ColinNg/PositronV3/CAD  files/3D printed Parts/Parametric Synchromesh Drive Pulley by Qiblical/Parametric_Synchromesh_Drive_Pulley_5427806/images/3_81_Synchromesh_Pulley.png

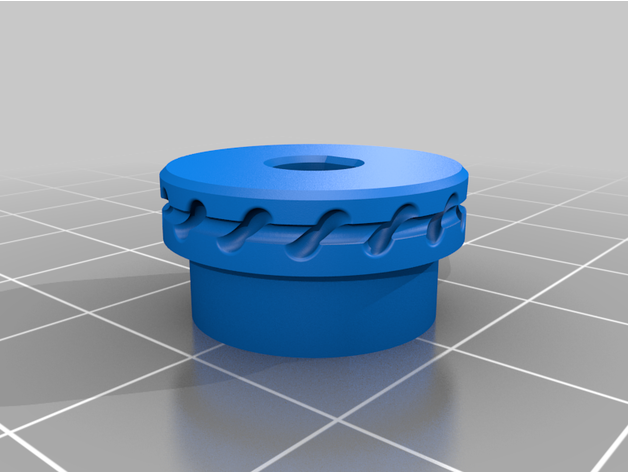
CAD files/3D printed Parts/Parametric Synchromesh Drive Pulley by Qiblical/Parametric_Synchromesh_Drive_Pulley_5427806/images/3_81_Synchromesh_Pulley.png
