ColinNg/PositronV3/CAD  files/3D printed Parts/Parametric Synchromesh Drive Pulley by Qiblical/Parametric_Synchromesh_Drive_Pulley_5427806/README.txt

Parametric Synchromesh Drive Pulley by Qiblical on Thingiverse: https://www.thingiverse.com/thing:5427806
