ColinNg/PositronV3/CAD  files/3D printed Parts/Parametric Synchromesh Drive Pulley by Qiblical/Parametric_Synchromesh_Drive_Pulley_5427806/images/featured_preview_IMG_20220710_001406016.jpg

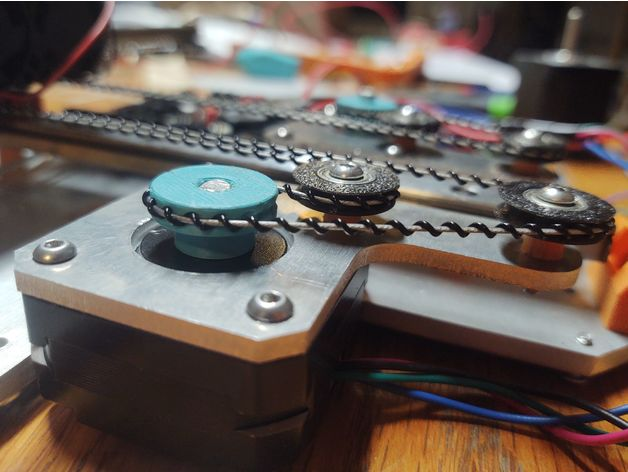
CAD files/3D printed Parts/Parametric Synchromesh Drive Pulley by Qiblical/Parametric_Synchromesh_Drive_Pulley_5427806/images/featured_preview_IMG_20220710_001406016.jpg
