ColinNg/PositronV3/CAD  files/3D printed Parts/Extruder Slider Arm.stl

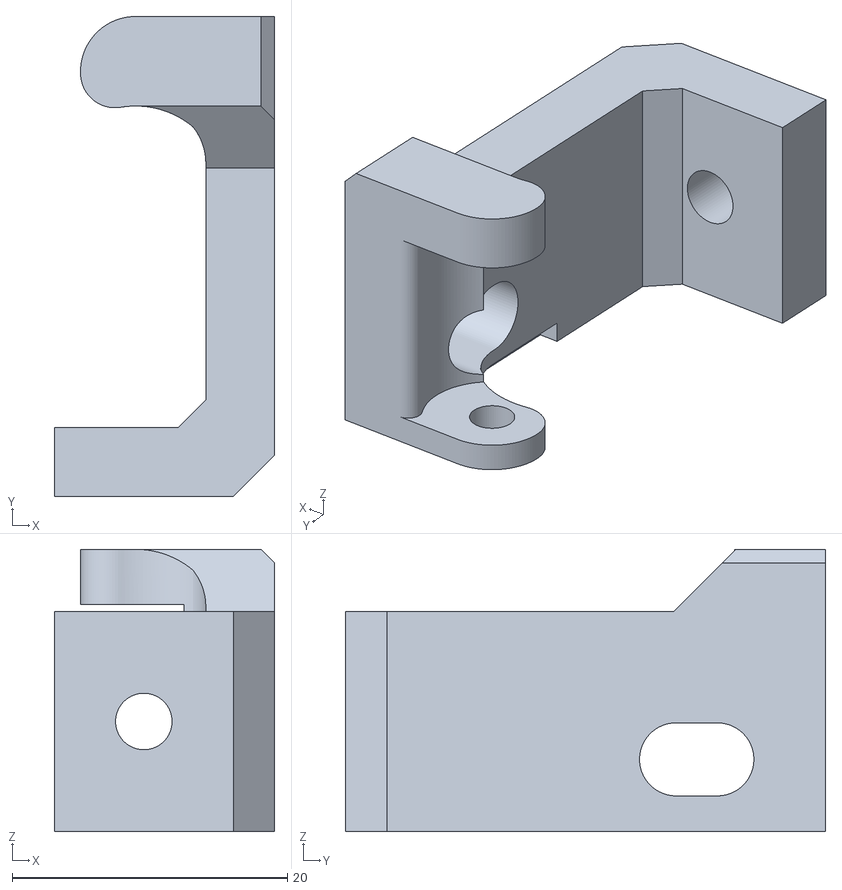
[picture p4: CAD file, 2025-05-02]
CAD files/3D printed Parts/Extruder Slider Arm.stl
16.0 x 34.9 x 20.5
