ColinNg/PositronV3/CAD  files/3D printed Parts/3D printed toolhead interconnect.stl

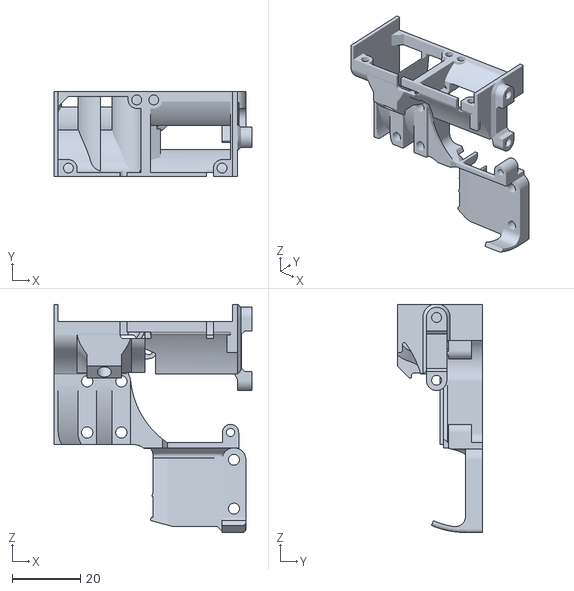
[picture p5: CAD file, 2023-12-30]
CAD files/3D printed Parts/3D printed toolhead interconnect.stl
57.9 x 25.0 x 66.8
