ColinNg/PositronV3/(list of files, cad)

Other CAD files:
CAD files/3D printed Parts/Parametric Synchromesh Drive Pulley by Qiblical/Parametric_Synchromesh_Drive_Pulley_5427806/files/Parametric_Synchromesh_Drive_Pulley_v15.f3d
