ColinNg/PositronV3/Toolhead PCB/Toolhead PCB.kicad_pcb

## KiCad design Toolhead PCB/Toolhead PCB.kicad_pcb (2025-11-05)

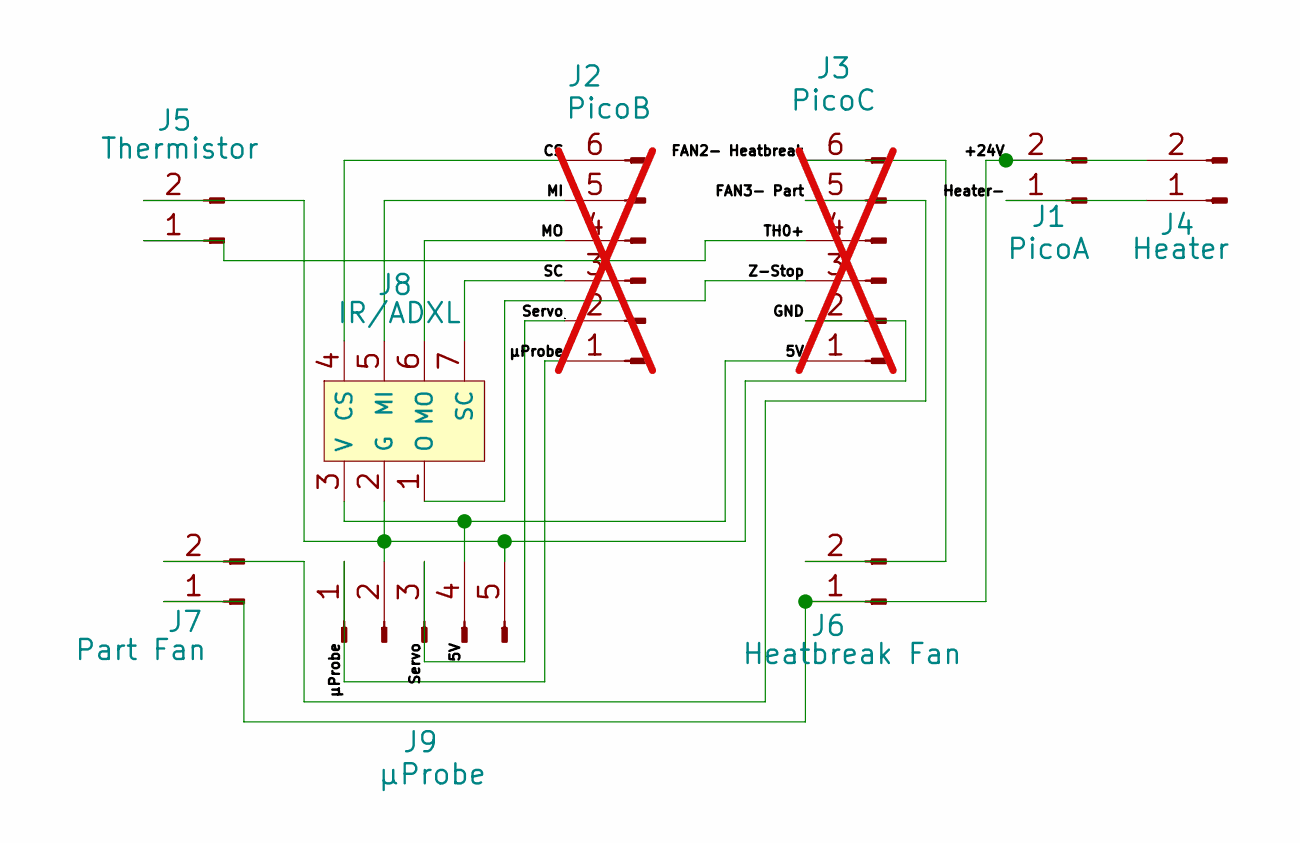
[picture p6: schematic Toolhead PCB.kicad_sch, JourneyMaker Toolhead PCB]

Parts:
J1: PicoA; SolderWire-0.5sqmm_1x02_P4.8mm_D0.9mm_OD2.3mm
J2: PicoB; JST_PH_B6B-PH-K_1x06_P2.00mm_Vertical; not fitted
J3: PicoC; JST_PH_B6B-PH-K_1x06_P2.00mm_Vertical; not fitted
J4: Heater; AMASS_XT30UPB-M_1x02_P5.0mm_Vertical
J5: Thermistor; JST_XH_S2B-XH-A_1x02_P2.50mm_Horizontal
J6: Heatbreak Fan; JST_XH_B2B-XH-A_1x02_P2.50mm_Vertical
J7: Part Fan; JST_XH_B2B-XH-A_1x02_P2.50mm_Vertical
J8: IR/ADXL; Muon 3D IR Bed Probe with ADXL345
J9: µProbe; JST_PH_B5B-PH-K_1x05_P2.00mm_Vertical

Connections:
/5V: J3.1, J8.3 (V), J9.4
/+24V: J1.2, J4.2, J6.1, J7.1
/CS: J2.6, J8.4 (CS)
/FAN2- Heatbreak: J3.6, J6.2
/FAN3- Part: J3.5, J7.2
/GND: J3.2, J5.2, J8.2 (G), J9.2, J9.5
/Heater-: J1.1, J4.1
/MI: J2.5, J8.5 (MI)
/MO: J2.4, J8.6 (MO)
/SC: J2.3, J8.7 (SC)
/Servo: J2.2, J9.3
/TH0+: J3.4, J5.1
/Z-Stop: J3.3, J8.1 (O)
/µProbe: J2.1, J9.1

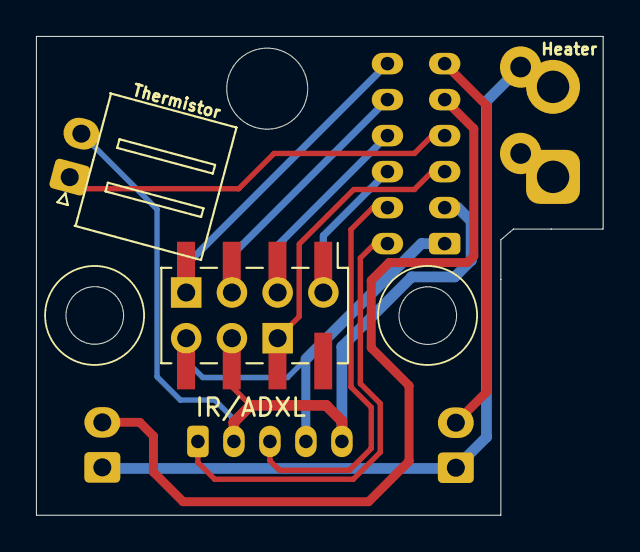
[picture p7: board Toolhead PCB.kicad_pcb from above]

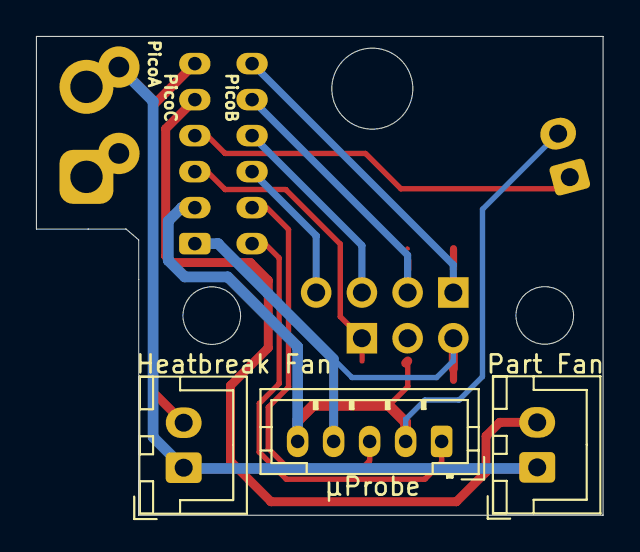
[picture p8: board Toolhead PCB.kicad_pcb from below]

Board: 2 copper layers, 31.5 x 26.6 mm, 12 parts (6 on the bottom side), 14 nets.

Other parts of the board:
Hole: Hole 3.2mm; MountingHole_3.2mm_M3
Hole#2: Capacitor Hole 4.5mm; MountingHole_4.5mm
Hole#3: Hole 3.2mm; MountingHole_3.2mm_M3
