ColinNg/PositronV3/(commit log)

2023-12-30 Parametric Synchromesh Drive Pulley by Qiblical on Thingiverse: https://www.thingiverse.com/thing:5427806
    [Parametric_Synchromesh_Drive_Pulley_v15.f3d]
2023-12-30 3D_printed_toolhead_interconnect_fixed.stl from Sample Name, Discord, 2022-10-20 07:57 https://discord.com/channels/977582747939897344/977582937853808730/1032668809204617317
    [3D printed toolhead interconnect.stl]
2023-12-30 Remove image of unintentional holes
2025-05-02 Fix typo in name
    [Extruder Slider Arm.stl]
2025-09-10 Initial commit of schematic for JourneyMaker Toolhead PCB: - J1 Amass XT30PW-M from SKR Pico for Hot End Heater - J2 JST PH 2.0 6-pin from SKR Pico for Muon IR Bed Probe and Fans - J3 JST PH 2.0 6-pi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
    [Toolhead PCB.kicad_pcb, Toolhead PCB.kicad_sch]
2025-09-10 Schematic and PCB for JourneyMaker Toolhead PCB: - J1 Soldered wires from SKR Pico for Hot End Heater - J2 JST PH 2.0 6-pin from SKR Pico for BQ MicroProbe and Muon IR Probe's ADXL345 - J3 JST PH 2.0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
    [Toolhead PCB.kicad_pcb, Toolhead PCB.kicad_sch]
2025-09-10 Used wider traces for heater, fans, thermistor, microprobe power, etc.
    [Toolhead PCB.kicad_pcb, Toolhead PCB.kicad_sch]
2025-09-10 Combine a through-hole and an SMD connector to get the passthrough holes and vias.
    [Toolhead PCB.kicad_pcb, Toolhead PCB.kicad_sch]
2025-09-10 JST connectors are soldered to the back: added 8 vias for signal and 2 vias for fan power. Added mounting holes (but have not resolved clearances).
    [Toolhead PCB.kicad_pcb]
2025-09-11 Holes for mounting. Moved traces to avoid holes. Moved most vias to the large pads. Changed the ADXLL345 wire order so it would route better. Made Schematic match PCB.
    [Toolhead PCB.kicad_pcb, Toolhead PCB.kicad_sch]
2025-09-11 Thicker traces for heater, fans, and shared ground or power.
    [Toolhead PCB.kicad_pcb]
2025-09-11 Changed vias to 0.75mm to match through hole components, avoiding one tool change.
    [Toolhead PCB.kicad_pcb]
2025-09-11 Shortened label on IR+ADXL345 --> IR/ADXL Set the IR/ADXL header to Do Not Populate, and Exclude from BOM
    [Toolhead PCB.kicad_pcb, Toolhead PCB.kicad_sch]
2025-09-29 Toolhead PCB: Exported Excellon Drill Files and Gerbers
    [Toolhead PCB-B_Cu.gbr, Toolhead PCB-B_Mask.gbr, Toolhead PCB-B_Paste.gbr, Toolhead PCB-B_Silkscreen.gbr, Toolhead PCB-Edge_Cuts.gbr, Toolhead PCB-F_Cu.gbr, Toolhead PCB-F_Mask.gbr, Toolhead PCB-F_Paste.gbr]
2025-09-29 Changed XT30 footprint from `Connector_AMASS:AMASS_XT30PW-F_1x02_P2.50mm_Horizontal` to `Connector_AMASS:AMASS_XT30UPB-F_1x02_P5.0mm_Vertical` so there would not be the extra pads and drills for the 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
    [Toolhead PCB-B_Cu.gbr, Toolhead PCB-B_Mask.gbr, Toolhead PCB-B_Paste.gbr, Toolhead PCB-B_Silkscreen.gbr, Toolhead PCB-Edge_Cuts.gbr, Toolhead PCB-F_Cu.gbr, Toolhead PCB-F_Mask.gbr, Toolhead PCB-F_Paste.gbr]
2025-09-29 Added 3 fake vias so we could get them drilled out in FlatCAM.
    [Toolhead PCB-B_Cu.gbr, Toolhead PCB-B_Mask.gbr, Toolhead PCB-B_Paste.gbr, Toolhead PCB-B_Silkscreen.gbr, Toolhead PCB-Edge_Cuts.gbr, Toolhead PCB-F_Cu.gbr, Toolhead PCB-F_Mask.gbr, Toolhead PCB-F_Paste.gbr]
2025-09-29 Basic FlatCAM with B_Cu.gbr, Edge_Cuts.gbr, and PTH.drl mirrored along X axis of Edge_Cuts.gbr. Added Alignment Drills.
2025-09-29 I'm able to save the CNC Jobs for drilling without corrupting the Toolhead PCB-PTH.drl data.
2025-09-29 Toolhead PCB FlatCAM CNC Jobs
2025-09-29 Changed via holes that were 0.3mm to 0.75mm for easier manufacturing.
    [Toolhead PCB.kicad_pcb]
2025-09-29 It recalculated all the fills when I generated new Gerbers.
    [Toolhead PCB-B_Cu.gbr, Toolhead PCB-B_Mask.gbr, Toolhead PCB-B_Paste.gbr, Toolhead PCB-B_Silkscreen.gbr, Toolhead PCB-Edge_Cuts.gbr, Toolhead PCB-F_Cu.gbr, Toolhead PCB-F_Mask.gbr, Toolhead PCB-F_Paste.gbr]
2025-09-29 Basic FlatCAM with B_Cu.gbr, Edge_Cuts.gbr, and PTH.drl mirrored along X axis of Edge_Cuts.gbr. Added Alignment Holes. Set Origin.
2025-09-29 Changed Alignment Drills to use a 2.4mm Corn Cob bit.
2025-09-29 Change the V-bit tip diameter to 0.1 so the FlatCAM geometry actually isolates the traces. Regenerated `03 Bottom Copper.nc`
2025-09-29 Moved the hole for the capacitor down by 0.4mm, and enlarged diameter by 0.5mm. Updated Edge Cuts circle to match. Exported Gerbers and Excellon files. Basic FlatCAM with B_Cu.gbr, Edge_Cuts.gbr, and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
    [Toolhead PCB-B_Cu.gbr, Toolhead PCB-B_Mask.gbr, Toolhead PCB-B_Paste.gbr, Toolhead PCB-B_Silkscreen.gbr, Toolhead PCB-Edge_Cuts.gbr, Toolhead PCB-F_Cu.gbr, Toolhead PCB-F_Mask.gbr, Toolhead PCB-F_Paste.gbr]
2025-09-29 Changed Mill Holes and Cutout to use a 2.0mm Upcut Conical Endmill.
2025-09-29 Created symbol and footprint for the Muon 3D IR Bed Probe with ADXL345.
    [Toolhead PCB.kicad_pcb, Toolhead PCB.kicad_sch]
2025-09-29 Labeled all the pins/nets. Moved connector Values to F.Silkscreen and moved connector References to F.Fab.
    [Toolhead PCB.kicad_pcb, Toolhead PCB.kicad_sch]
2025-09-30 Redesigned PCB: - narrower so it does not protrude as much past the boundary when the Positron is packed for storage - all traces on front side only (no more manually soldered vias); still recommend 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
    [Toolhead PCB.kicad_pcb, Toolhead PCB.kicad_sch]
2025-09-30 Basic FlatCAM with B_Cu.gbr, Edge_Cuts.gbr, NPTH.drl, and PTH.drl mirrored along X axis of Edge_Cuts.gbr. Added Alignment Holes. Set Origin.
    [Toolhead PCB-B_Cu.gbr, Toolhead PCB-B_Mask.gbr, Toolhead PCB-B_Paste.gbr, Toolhead PCB-B_Silkscreen.gbr, Toolhead PCB-Edge_Cuts.gbr, Toolhead PCB-F_Cu.gbr, Toolhead PCB-F_Mask.gbr, Toolhead PCB-F_Paste.gbr]
2025-09-30 Move alignment holes. Renamed .nc files with `E3-175` for Endmill 3.175mm.
2025-09-30 Changed Silkscreen labels.
    [Toolhead PCB.kicad_pcb, Toolhead PCB.kicad_sch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]
2025-10-01 Widened traces to tolerate overmilling.
    [Toolhead PCB-B_Cu.gbr, Toolhead PCB-B_Mask.gbr, Toolhead PCB-B_Paste.gbr, Toolhead PCB-B_Silkscreen.gbr, Toolhead PCB-Edge_Cuts.gbr, Toolhead PCB-F_Cu.gbr, Toolhead PCB-F_Mask.gbr, Toolhead PCB-F_Paste.gbr]
2025-10-01 Regenerated CNC Jobs, adding a Realignment job in case I want to use the same holes in the spoilboard to make another PCB.
2025-10-03 Regenerated CNC Jobs for spindle speed 10,000.
2025-10-03 Schematic more closely matches traces. Updated PicoB and PicoC wiring harnesses: flagged as non populated and deleted silkscreen. Removed pins from Muon 3D IR Bed Probe with ADXL345. Moved traces fro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
    [Toolhead PCB.kicad_pcb, Toolhead PCB.kicad_sch]
2025-10-08 Changed V-bit to 15° 0.1mm. Changed order of milling (mill the Top Copper first, after it succeeds mill the alignment holes). Changed Endmill to 2.0mm.
2025-10-10 The 0.75mm holes do not retain the Silicone 28AWG Ribbon Cable wires properly, so the Schematic and PCB use a new footprint `SolderWire-0.1sqmm_1x06_P2.0mm_D0.4mm_OD1mm.kicad_mod` which has the same 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
    [Toolhead PCB-B_Cu.gbr, Toolhead PCB-B_Mask.gbr, Toolhead PCB-B_Paste.gbr, Toolhead PCB-B_Silkscreen.gbr, Toolhead PCB-Edge_Cuts.gbr, Toolhead PCB-F_Cu.gbr, Toolhead PCB-F_Mask.gbr, Toolhead PCB-F_Paste.gbr]
2025-11-05 Duplicated the `Toolhead PCB` folder to `Toolhead PCB CNC`.
    [Toolhead PCB-B_Cu.gbr, Toolhead PCB-B_Mask.gbr, Toolhead PCB-B_Paste.gbr, Toolhead PCB-B_Silkscreen.gbr, Toolhead PCB-Edge_Cuts.gbr, Toolhead PCB-F_Cu.gbr, Toolhead PCB-F_Mask.gbr, Toolhead PCB-F_Paste.gbr]
2025-11-05 [2025-10-03] Moved most power traces to the back so I they could be wider while the board got narrower on the right side.
    [Toolhead PCB.kicad_pcb, Toolhead PCB.kicad_sch]
2025-11-05 [2025-10-03] Gerbers submitted to JLCPCB.
    [Toolhead PCB-B_Cu.gbr, Toolhead PCB-B_Mask.gbr, Toolhead PCB-B_Paste.gbr, Toolhead PCB-B_Silkscreen.gbr, Toolhead PCB-Edge_Cuts.gbr, Toolhead PCB-F_Cu.gbr, Toolhead PCB-F_Mask.gbr, Toolhead PCB-F_Paste.gbr]
